ag4015/articulated-glove/articulatedGlove1.jpg

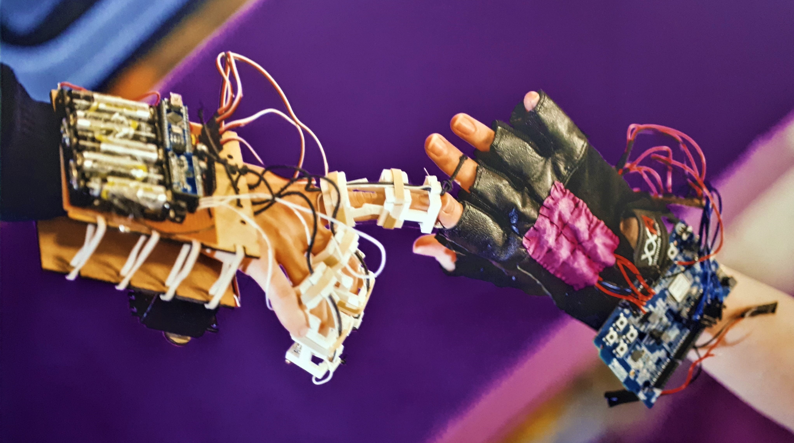
articulatedGlove1.jpg
