ag4015/articulated-glove/Picture3(2).jpg

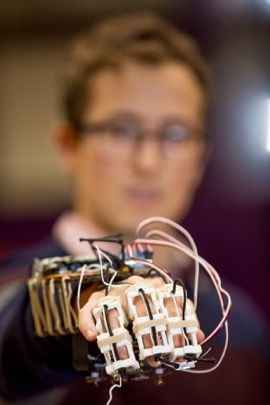
Picture3(2).jpg
