ag4015/articulated-glove/README.md

# articulated-glove
Project aimed at helping people with hand disabilities
