ag4015/articulated-glove/circuit diagram.png

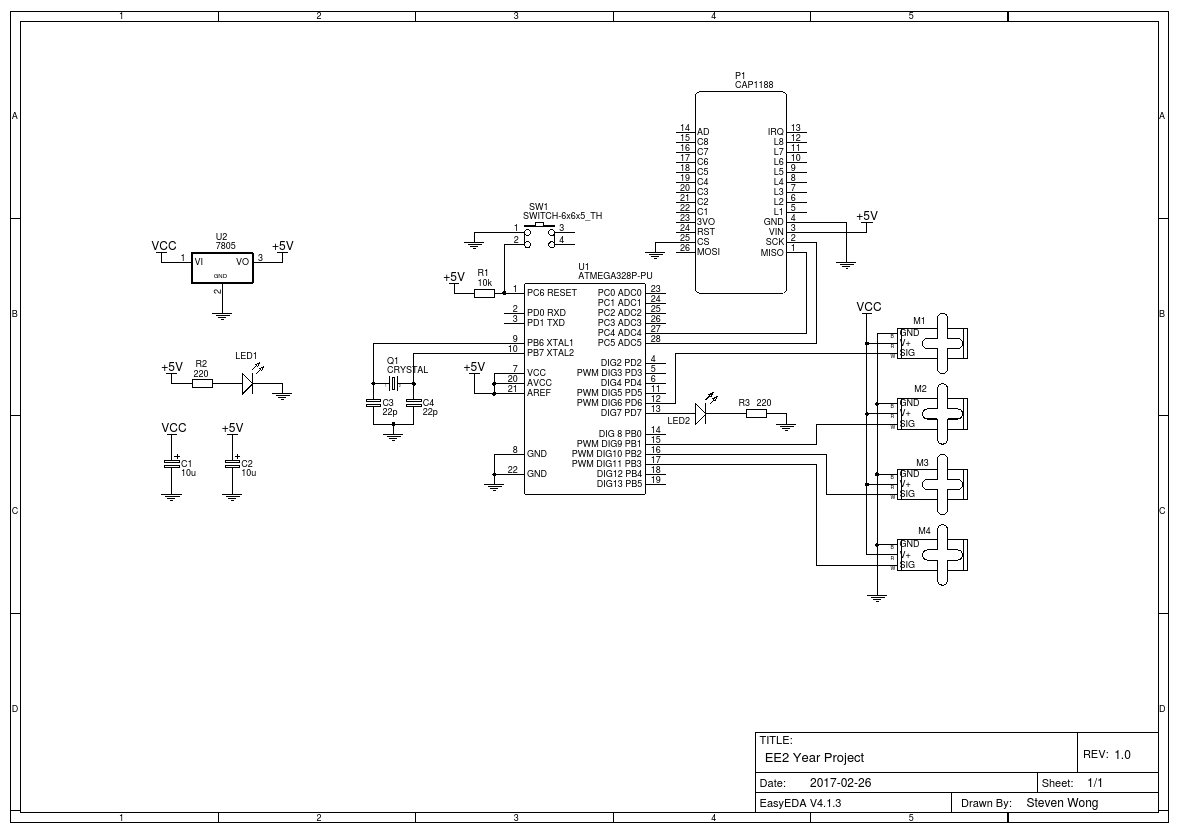
circuit diagram.png
